Kamalesh9483/Agricutural_Mobile_Robot/20220624_193238.jpg

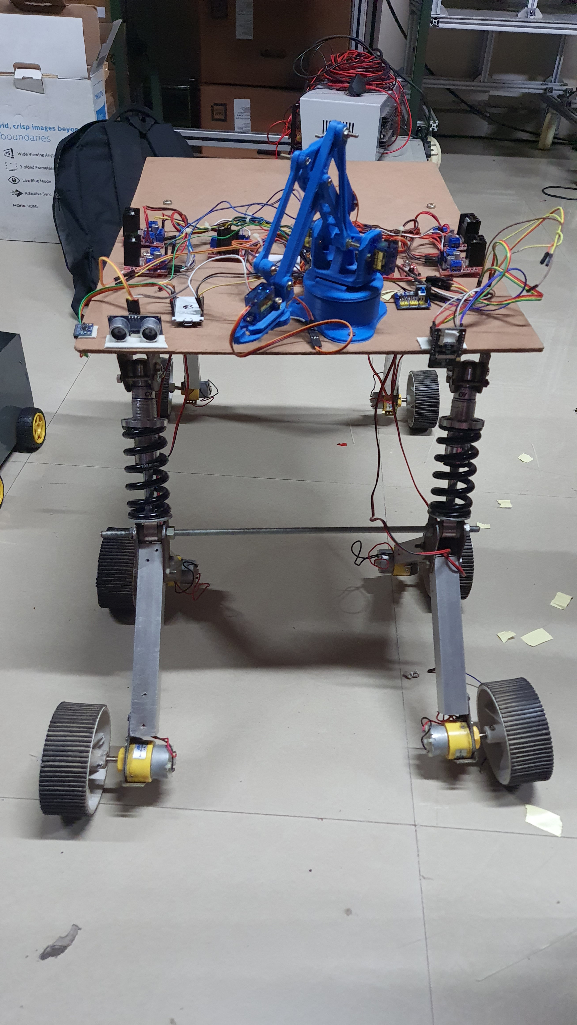
20220624_193238.jpg
