Kamalesh9483/Agricutural_Mobile_Robot/Web_Server_RobotArm_/ESP32_MPU_6050_Web_Server_RobotArm_Ultrsonic/ESP32_MPU_6050_Web_Server_RobotArm_Ultrsonic.ino

#include <Arduino.h>
#include <WiFi.h>
#include <AsyncTCP.h>
#include <ESPAsyncWebServer.h>
#include <Adafruit_MPU6050.h>
#include <Adafruit_Sensor.h>
#include <Arduino_JSON.h>
#include "SPIFFS.h"
#include <ESP32Servo.h>


Servo myservo_gripper;  // create servo object to control a servo
Servo myservo_base;
Servo myservo_arm_left;
Servo myservo_arm_right;

// GPIO the servo is attached to
static const int servoP_gripper = 13;
static const int servoP_base = 12;
static const int servoP_arm_left = 14;
static const int servoP_arm_right = 27;

// Replace with your network credentials
const char* ssid = "OnePlus 5T";
const char* password = "c813da74egys";

// Create AsyncWebServer object on port 80
AsyncWebServer server(80);

// Create an Event Source on /events
AsyncEventSource events("/events");

// Json Variable to Hold Sensor Readings
JSONVar readings;


// Variable to store the HTTP request
String header;

// Decode HTTP GET value
String valueString_gripper = String(4);
String valueString_base = String(5);
String valueString_arm_left = String(6);
String valueString_arm_right = String(6);
int pos1 = 0;
int pos2 = 0;
int pos3 = 0;
int pos4 = 0;
int pos5 = 0;
int pos6 = 0;
int pos7 = 0;
int pos8 = 0;




// Timer variables
unsigned long lastTime = 0;  
unsigned long lastTimeTemperature = 0;
unsigned long lastTimeAcc = 0;
unsigned long gyroDelay = 10;
unsigned long temperatureDelay = 1000;
unsigned long accelerometerDelay = 200;
unsigned long lastTimeUltra = 0;

//Ultrasonic
const int trigPin = 5;
const int echoPin = 18;
unsigned long ultraSoundDelay = 1000;

//define sound speed in cm/uS
#define SOUND_SPEED 0.034
#define CM_TO_INCH 0.393701

long duration;
float distanceCm;
float distanceInch;

// Create a sensor object
Adafruit_MPU6050 mpu;

sensors_event_t a, g, temp;

float gyroX, gyroY, gyroZ;
float accX, accY, accZ;
float temperature;

//Gyroscope sensor deviation
float gyroXerror = 0.07;
float gyroYerror = 0.03;
float gyroZerror = 0.01;

// Init MPU6050
void initMPU(){
  if (!mpu.begin()) {
    Serial.println("Failed to find MPU6050 chip");
    while (1) {
      delay(10);
    }
  }
  Serial.println("MPU6050 Found!");
}

void initSPIFFS() {
  if (!SPIFFS.begin()) {
    Serial.println("An error has occurred while mounting SPIFFS");
  }
  Serial.println("SPIFFS mounted successfully");
}

// Initialize WiFi
void initWiFi() {
  WiFi.mode(WIFI_STA);
  WiFi.begin(ssid, password);
  Serial.println("");
  Serial.print("Connecting to WiFi...");
  while (WiFi.status() != WL_CONNECTED) {
    Serial.print(".");
    delay(1000);
  }
  Serial.println("");
  Serial.println(WiFi.localIP());
}

String getGyroReadings(){
  mpu.getEvent(&a, &g, &temp);

  float gyroX_temp = g.gyro.x;
  if(abs(gyroX_temp) > gyroXerror)  {
    gyroX += gyroX_temp/50.00;
  }
  
  float gyroY_temp = g.gyro.y;
  if(abs(gyroY_temp) > gyroYerror) {
    gyroY += gyroY_temp/70.00;
  }

  float gyroZ_temp = g.gyro.z;
  if(abs(gyroZ_temp) > gyroZerror) {
    gyroZ += gyroZ_temp/90.00;
  }

  readings["gyroX"] = String(gyroX);
  readings["gyroY"] = String(gyroY);
  readings["gyroZ"] = String(gyroZ);

  String jsonString = JSON.stringify(readings);
  return jsonString;
}

String getAccReadings() {
  mpu.getEvent(&a, &g, &temp);
  // Get current acceleration values
  accX = a.acceleration.x;
  accY = a.acceleration.y;
  accZ = a.acceleration.z;
  readings["accX"] = String(accX);
  readings["accY"] = String(accY);
  readings["accZ"] = String(accZ);
  String accString = JSON.stringify (readings);
  return accString;
}

String getTemperature(){
  mpu.getEvent(&a, &g, &temp);
  temperature = temp.temperature;
  return String(temperature);
}

String getUltraSoundReadings(){
  // Clears the trigPin
  digitalWrite(trigPin, LOW);
  delayMicroseconds(2);
  Serial.println("DWlow");
  // Sets the trigPin on HIGH state for 10 micro seconds
  digitalWrite(trigPin, HIGH);
  delayMicroseconds(10);
  Serial.println("DWhigh");
  digitalWrite(trigPin, LOW);
  
  // Reads the echoPin, returns the sound wave travel time in microseconds
  duration = pulseIn(echoPin, HIGH);
  Serial.println("Duration");
  // Calculate the distance
  distanceCm = duration * SOUND_SPEED/2;
  
  // Prints the distance in the Serial Monitor
  Serial.print("Distance (cm): ");
  Serial.println(distanceCm);

  readings["ultraSonicString"] = String(distanceCm);
  String ultraSonicString = JSON.stringify (readings);
   Serial.println("Before return");
  return ultraSonicString;
  delay(1000);
  }


void setup() {
  Serial.begin(115200);
  initWiFi();
  initSPIFFS();
  initMPU();
  pinMode(trigPin, OUTPUT); // Sets the trigPin as an Output
  pinMode(echoPin, INPUT); // Sets the echoPin as an Input

  myservo_gripper.attach(servoP_gripper);  // attaches the servo on the servoP_gripperin_gripper to the servo object
  myservo_base.attach(servoP_base);  
  myservo_arm_left.attach(servoP_arm_left);  
  myservo_arm_right.attach(servoP_arm_right);


  // Handle Web Server
  server.on("/", HTTP_GET, [](AsyncWebServerRequest *request){
    request->send(SPIFFS, "/index.html", "text/html");
  });

  server.serveStatic("/", SPIFFS, "/");

  server.on("/reset", HTTP_GET, [](AsyncWebServerRequest *request){
    gyroX=0;
    gyroY=0;
    gyroZ=0;
    request->send(200, "text/plain", "OK");
  });

  server.on("/resetX", HTTP_GET, [](AsyncWebServerRequest *request){
    gyroX=0;
    request->send(200, "text/plain", "OK");
  });

  server.on("/resetY", HTTP_GET, [](AsyncWebServerRequest *request){
    gyroY=0;
    request->send(200, "text/plain", "OK");
  });

  server.on("/resetZ", HTTP_GET, [](AsyncWebServerRequest *request){
    gyroZ=0;
    request->send(200, "text/plain", "OK");
  });

  server.on("/ultraSound", HTTP_GET, [](AsyncWebServerRequest *request){

    request->send(200, "text/plain", "OK");
  });

    server.on("/gripper", HTTP_GET, [](AsyncWebServerRequest *request){

    request->send(200, "text/plain", "OK");
  });

  // Handle Web Server Events
  events.onConnect([](AsyncEventSourceClient *client){
    if(client->lastId()){
      Serial.printf("Client reconnected! Last message ID that it got is: %u\n", client->lastId());
    }
    // send event with message "hello!", id current millis
    // and set reconnect delay to 1 second
    client->send("hello!", NULL, millis(), 10000);
  });
  server.addHandler(&events);

  server.begin();
}

void loop() {
  if ((millis() - lastTime) > gyroDelay) {
    // Send Events to the Web Server with the Sensor Readings
    events.send(getGyroReadings().c_str(),"gyro_readings",millis());
    lastTime = millis();
    Serial.println("Gyro");
  }
  if ((millis() - lastTimeAcc) > accelerometerDelay) {
    // Send Events to the Web Server with the Sensor Readings
    events.send(getAccReadings().c_str(),"accelerometer_readings",millis());
    lastTimeAcc = millis();
  }
  if ((millis() - lastTimeTemperature) > temperatureDelay) {
    // Send Events to the Web Server with the Sensor Readings
    events.send(getTemperature().c_str(),"temperature_reading",millis());
    lastTimeTemperature = millis();
      }
     if ((millis() - lastTimeUltra) > ultraSoundDelay) {
    // Send Events to the Web Server with the Sensor Readings
    events.send(getUltraSoundReadings().c_str(),"ultraSound_readings",millis());
    lastTimeUltra = millis();
     Serial.println("Ultras");
     
  }
//getUltraSoundReadings();
}
