Kamalesh9483/Agricutural_Mobile_Robot/(commit log)

2022-07-25 Add files via upload
    ESP32cam with Robot maneouvre uploaded
2022-07-25 Add files via upload
    Included codes for Robot Arm control, Ultrasonic, Gyroscope, Acceleromtere sensor read in a webpage
2022-07-25 Add files via upload
    Included codes for Ultrasonic sensor store in Database
2022-07-25 Add files via upload
    Dissertation2 Report attached
2022-07-25 Add files via upload
    Robot Arm Video uploaded
2022-07-25 Add files via upload
    Added Final Robot Maneouvering and Robotic Arm control
2022-07-25 Add files via upload
    Merged GIF Final - contains both Robot movement control and Robotiv Arm control
